gom9000/kis-modular-presepe-lights/README.md

# *Keep It Simple*
The concept behind *Keep-It-Simple* is to build simple solutions using only a few general-purpose, easy-to-manage components, without MCUs or programmable devices... solder & play!

# Modular Presepe Lights
A set of simple modular circuits for the lighting of the presepe.
<br/>
The idea is to make a very simple lights controller, with a modular approach depending on the needs, to drive low-current (and short) LED strings, with an external supply voltage between 12 and 15 VDC.

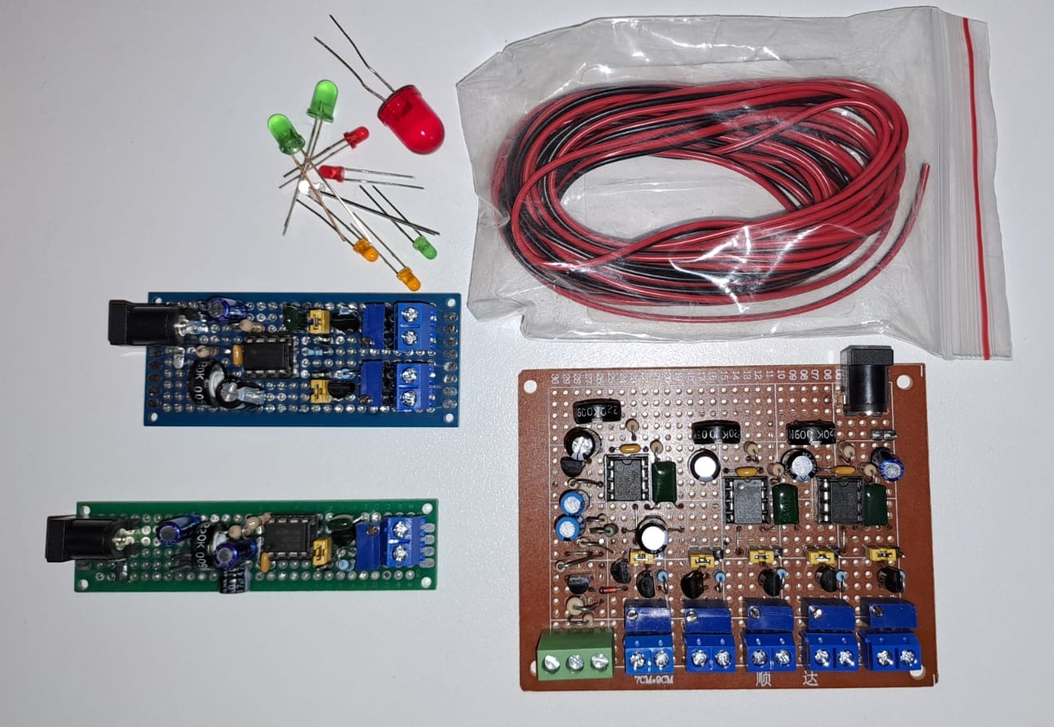
[picture p1: resources/overview.jpg]
overview


## Modules

### LED Driver Module
Is the only mandatory module, implemented with a LM317 configured as a constant current source.
This simple configuration is capable to drive a LED string that has a drop voltage of less than $Vin$ minus a few volts.

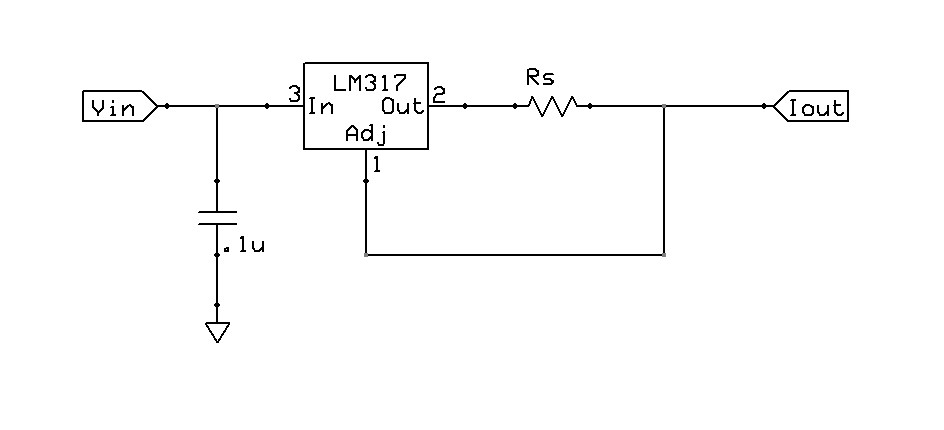
[picture p2: resources/led-driver-module-schematic.jpg]


The output current of this circuit is:

$$ I_{out} = 1.25/R_{s} $$

### Intermittence Module
A variable frequency astable multivibrator that acts as intermittence, implemented with a 555 timer.

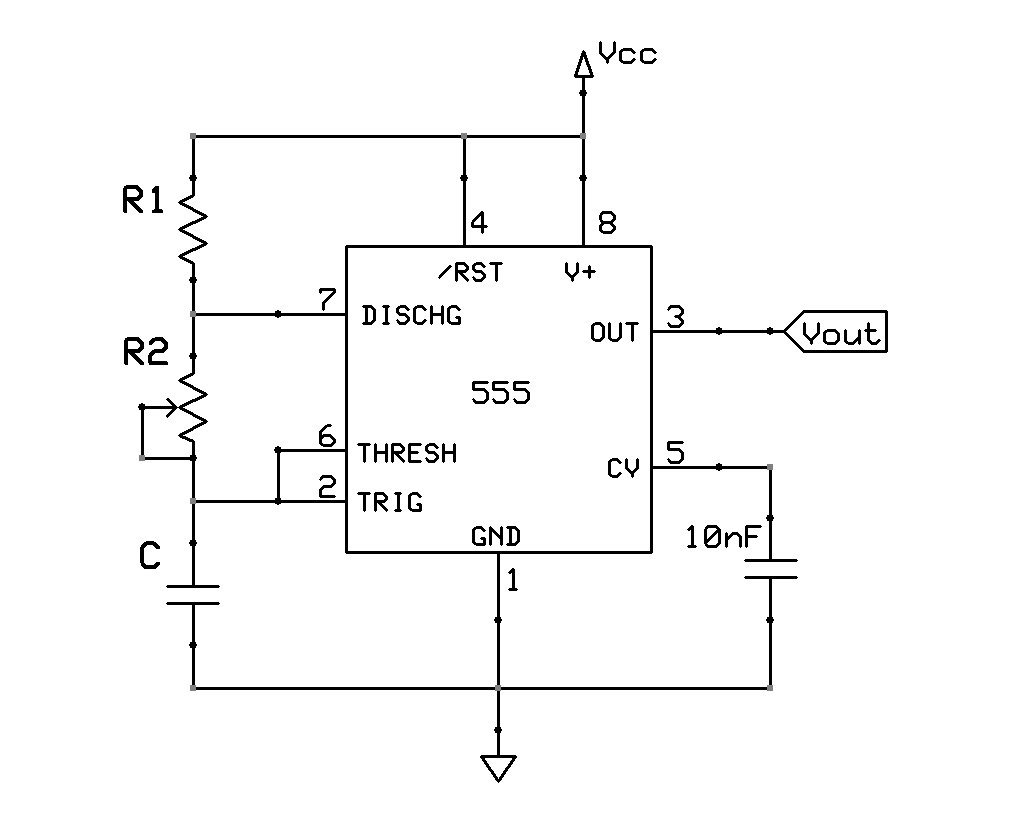
[picture p3: resources/intermittence-module-schematic.jpg]


A rectangular voltage signal of approximately $Vout = Vcc-1.5V$ is obtained as output.
<br/>
Circuit timing equations are:

$$ period = 0,69*(R_{1} + 2R_{2})*C $$

$$ dutycycle = \large\frac{R_{1} + R_{2}}{R_{1} + 2R_{2}} $$

### Firelight Module
A fixed frequency astable multivibrator "disturbed" by a simple relaxaction oscillator, to emulate the irregular tremolo of firelight.

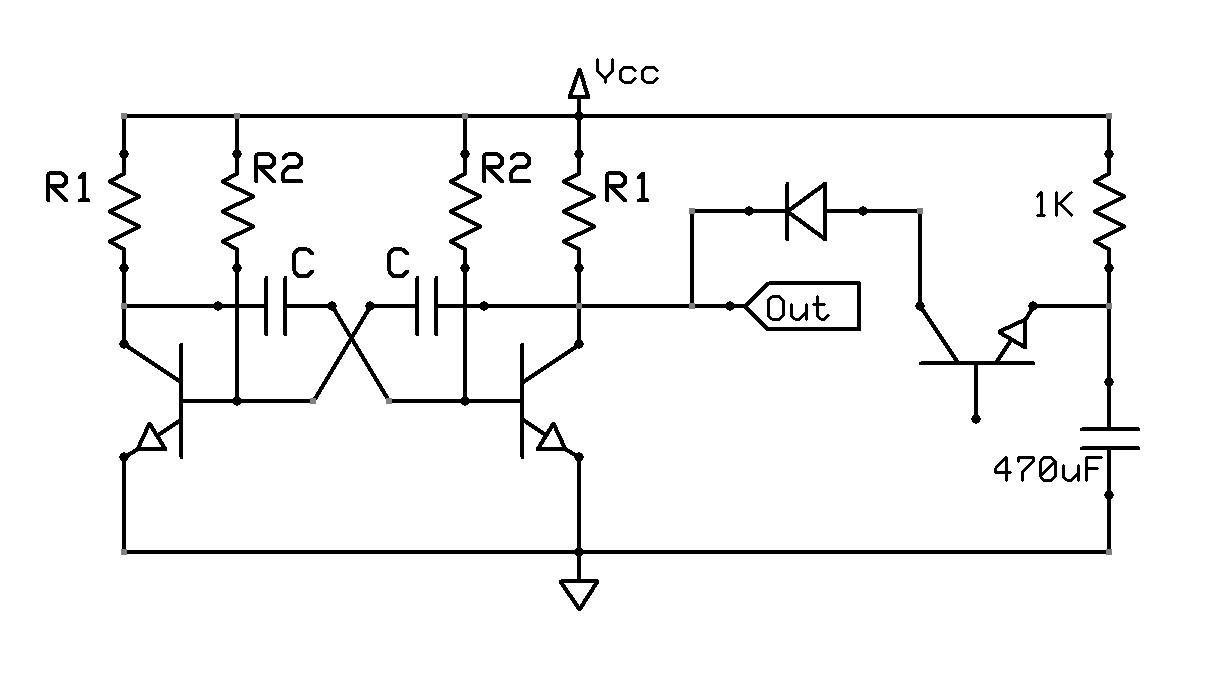
[picture p4: resources/firelight-module-schematic.jpg]


### Starlight Module
The same circuit of the firelight module, but with a slightly faster frequency.

### LED string Module
A series of max 4 or 5 small-current LEDs. The maximum drop voltage must be less than $V_{out}$ minus a few volts.

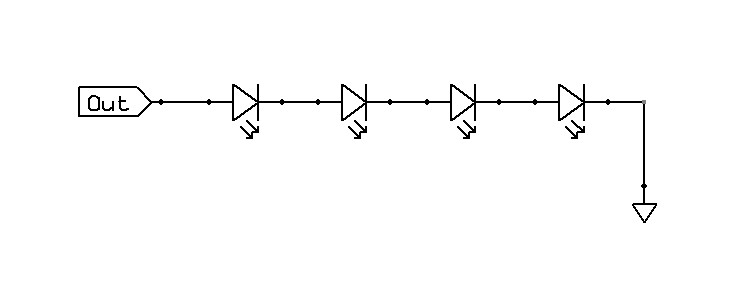
[picture p5: resources/led-string-module-schematic.jpg]


Typical (but very very indicative) LED voltage drop, based on color, are:

$$ red \sim (1.6 - 2.0)V $$

$$ orange \sim 2.0V $$

$$ yellow \sim 2.0V $$

$$ green \sim (1.9 - 4.0)V $$

$$ blu \sim (2.5 - 3.7)V $$

$$ white \sim (3.2 - 4.0)V $$

## Boards
- [Tiny Board](boards/tiny-board) implements a single line configurable intermittence board.
- [Small Board](boards/small-board) implements a configurable board with 1 intermittence module capable of drive 2 LED-strings.
- [Medium Board](boards/medium-board) implements a configurable board with 3 intermittence modules capable of drive 5 LED-strings, plus a firelight set.

## About
Author : Alessandro Fraschetti (mail: [gos95@gommagomma.net](mailto:gos95@gommagomma.net))

## Licence
The [MIT license](LICENSE) posted in the main repository directory is applied to all the stuff.
You are free to use them for any purpose, just try to give credit in the documentation of your project.
