gom9000/kis-modular-presepe-lights/boards/small-board/README.md

# *Small* Board
Configurable board with 1 intermittence module capable of drive 2 LED-strings.
The light intensity can be varied via trimmers T2/T3,
and the period of intermittence can be varied using the T1 trimmer, between about 5 and 20 seconds.
The intermittence module can be plugged to none, one or both the drivers via J1/J2 jumpers.

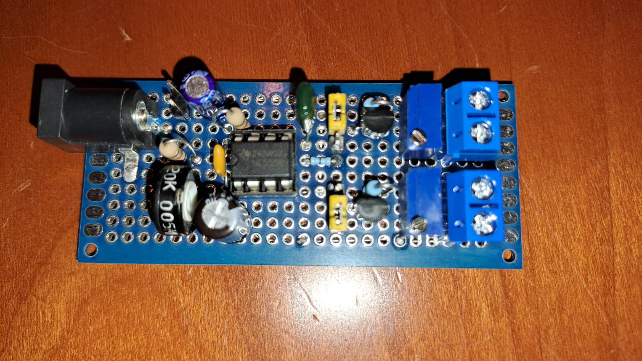
[picture p6: boards/small-board/small-board_built.jpg]
board-built


## Schematic
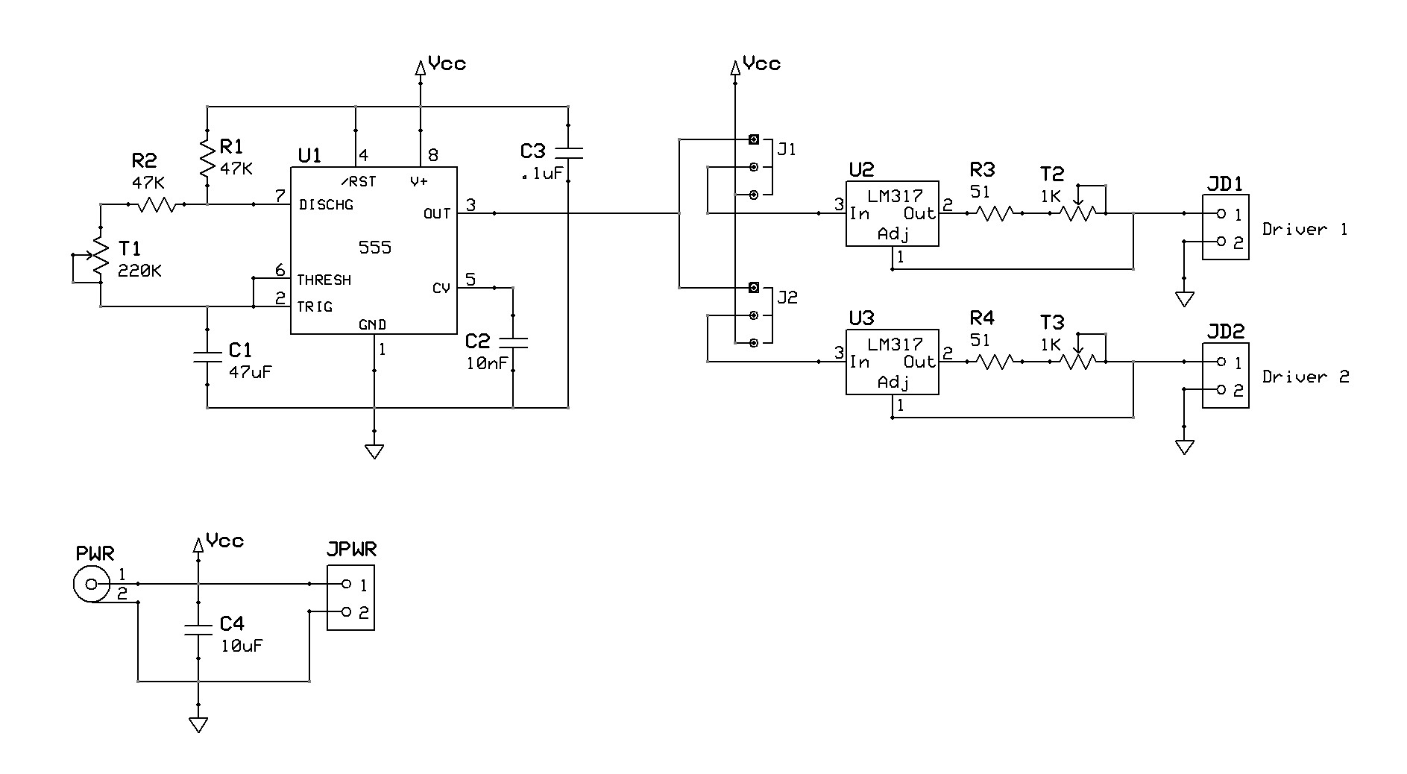
[picture p7: boards/small-board/small-board_sch.jpg]
board-schematic


## PCB Layout
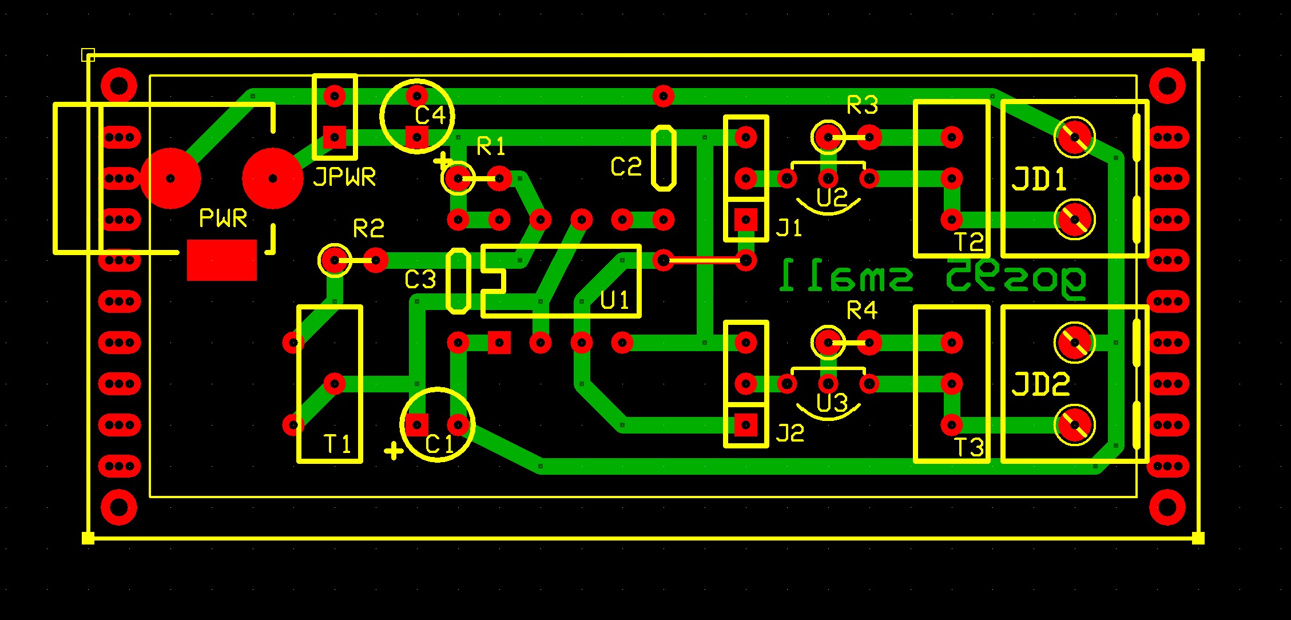
[picture p8: boards/small-board/small-board_pcb.jpg]
board-pcb


## Bill of Materials
- [x] paperboard 3x7cm (10x24 holes)
- [x] 1 x IC 555 timer
- [x] 2 x IC LM317 3-terminal adjustable regulator
- [x] 2 x 47Kohm resistors 1/4 watt
- [x] 2 x 51ohm resistors 1/4 watt
- [x] 2 x 1Kohm trimmers
- [x] 1 x 220Kohm trimmers
- [x] 47uF electrolytic capacitor 25V
- [x] 10uF electrolytic capacitor 25V
- [x] 1 x 100nF capacitor 25V
- [x] 1 x 10nF capacitor 25V
- [x] DC male power connector 2.1mm
- [x] 2-pin screw terminal block 5mm
- [x] 2-pin header
