gom9000/kis-modular-presepe-lights/boards/medium-board/README.md

# *Medium* Board
Board with 3 configurable intermittence modules capable of drive 5 LED-strings, plus a firelight set.
The light intensity can be varied via trimmers T4-T8,
and the period of intermittence can be varied using the T1-T3 trimmers, between about 5 and 20 seconds. 
The firelight set consists of a fixed LED output and a tremolo LED output (red+orange?).
The intermittence modules can be plugged to none, one or two drivers by J1-J5 jumpers.

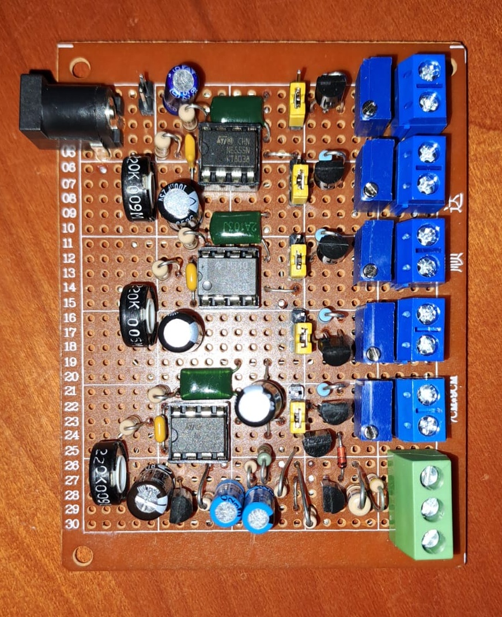
[picture p9: boards/medium-board/medium-board_built.jpg]
board-built


## Schematic
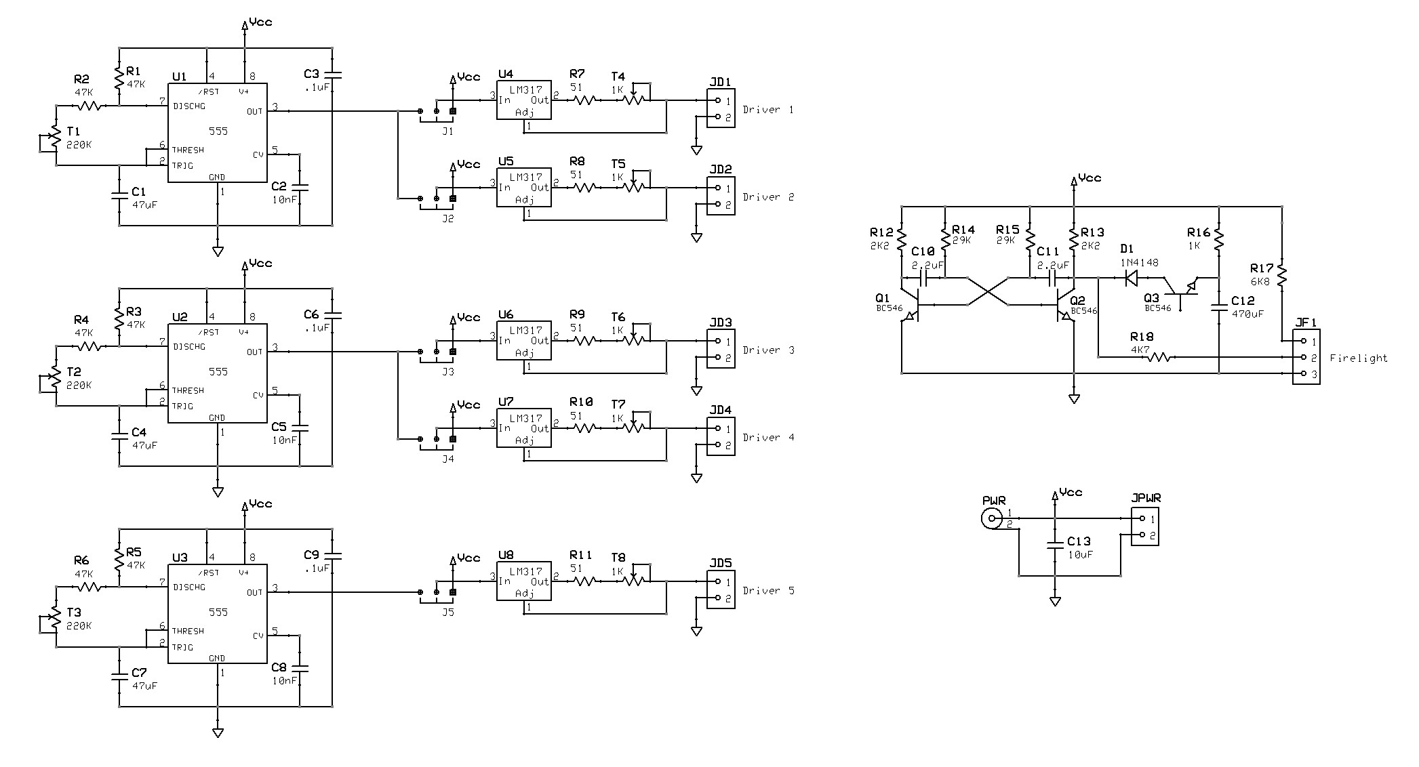
[picture p10: boards/medium-board/medium-board_sch.jpg]
board-schematic


## PCB Layout
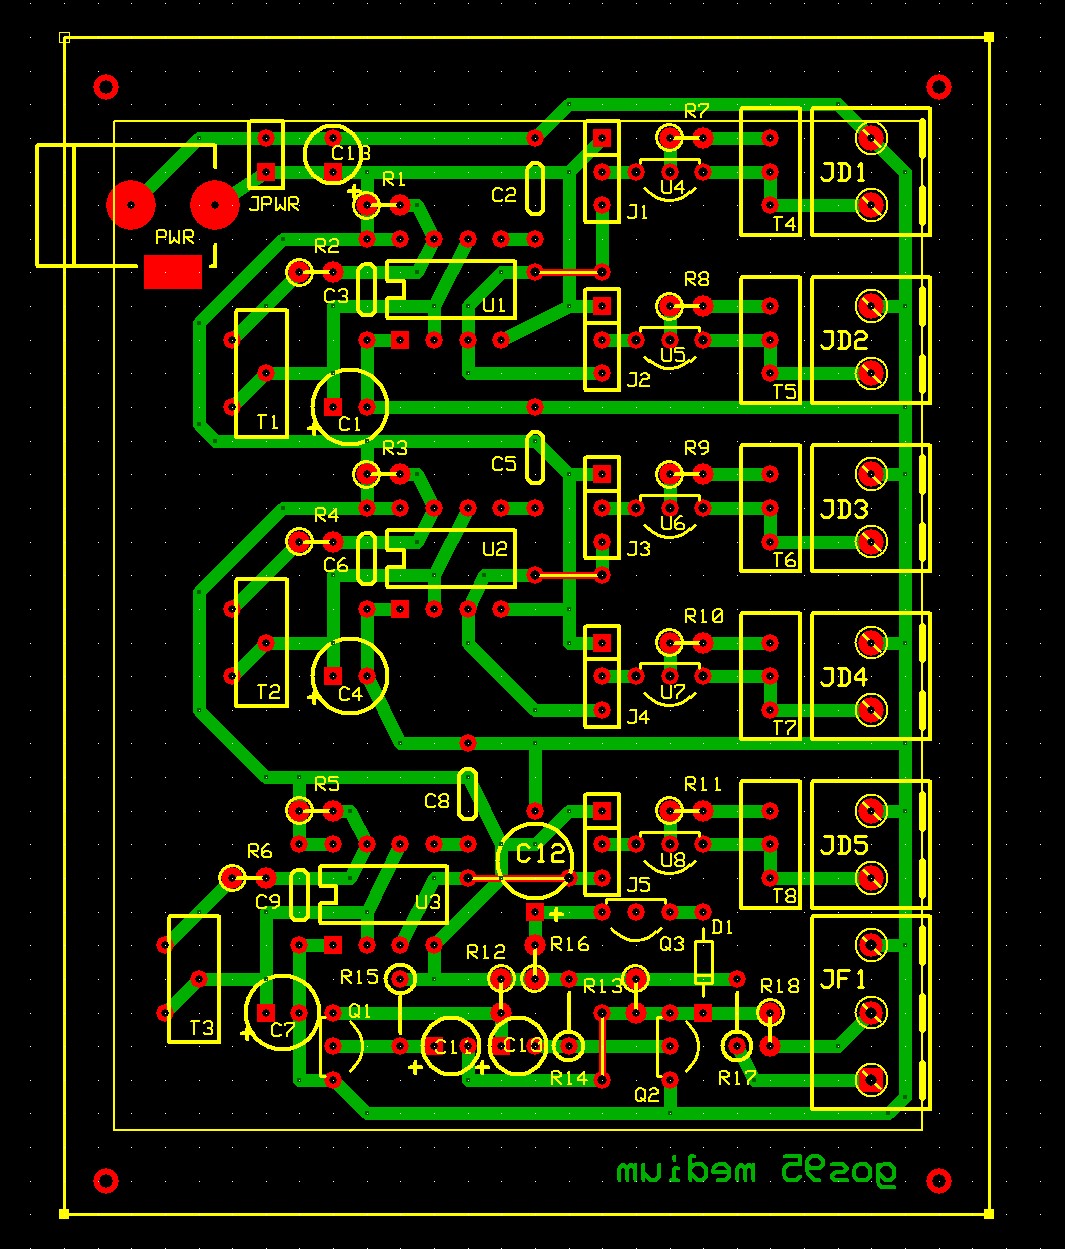
[picture p11: boards/medium-board/medium-board_pcb.jpg]
board-pcb


## Bill of Materials
- [x] paperboard 7x9cm
- [x] 3 x IC 555 timer
- [x] 5 x IC LM317 3-terminal adjustable regulator
- [x] 3 x Transistor BJT NPN for low current
- [x] diode for small signal
- [x] 6 x 47Kohm resistors 1/4 watt
- [x] 2 x 29Kohm resistors 1/4 watt
- [x] 6.8Kohm resistors 1/4 watt
- [x] 4.7Kohm resistors 1/4 watt
- [x] 2 x 2.2Kohm resistors 1/4 watt
- [x] 1Kohm resistors 1/4 watt
- [x] 5 x 51ohm resistors 1/4 watt
- [x] 5 x 1Kohm trimmers
- [x] 3 x 220Kohm trimmers
- [x] 470uF electrolytic capacitors 25V
- [x] 3 x 47uF electrolytic capacitors 25V
- [x] 10uF electrolytic capacitors 25V
- [x] 2 x 2.2uF electrolytic capacitors 25V
- [x] 3 x 100nF capacitors 25V
- [x] 3 x 10nF capacitors 25V
- [x] DC male power connector 2.1mm
- [x] 5 x 2-pin screw terminal block 5mm
- [x] 3-pin screw terminal block 5mm
- [x] 2-pin header
