gom9000/kis-modular-presepe-lights/(list of files, drawings)

Other design files:
boards/medium-board/medium-board.pcb
boards/small-board/small-board.pcb
boards/tiny-board/tiny-board.pcb
