gom9000/kis-modular-presepe-lights/(commit log)

2025-01-03 created repository with README
    [modules.sch]
2025-01-06 added mixed-7-board schematic
    [mixed-7-board.sch, modules.sch]
2025-01-19 added intermittence-1-board
    [intermittence-1-board.pcb, intermittence-1-board.sch, mixed-7-board.sch]
2025-01-23 refactored boards, added tiny board
    [intermittence-1-board.pcb, intermittence-1-board.sch, medium-board.pcb, medium-board.sch, tiny-board.pcb, tiny-board.sch]
2025-01-24 added small and medium boards schematics, refactored tiny-board part names
    [medium-board.pcb, medium-board.sch, small-board.sch, tiny-board.pcb, tiny-board.sch]
2025-01-24 Refactored repo name
    [medium-board.sch, modules.sch, small-board.sch, tiny-board.sch]
2025-01-24 add small-board pcb
    [small-board.pcb]
2025-01-26 update tiny board (enable/disable intermittence via J1)
    [medium-board.pcb, tiny-board.pcb, tiny-board.sch]
2025-01-26 added tyny-board built
    [tiny-board.pcb]
2025-01-26 fix astable capacitor value (10 -> 47uF)
    [medium-board.sch, small-board.sch, tiny-board.sch]
2025-02-01 updated small board pcb to 3x7 paperboard
    [small-board.pcb]
2025-02-02 add tiny and small built boards
2025-02-09 add medium board pcb
    [medium-board.pcb, medium-board.sch]
2025-02-15 add medium board built image
    [medium-board.pcb]
2025-02-15 fix medium board pcb
    [medium-board.pcb]
